9Volts2Ground/RBE598/latex/RBE598_Project.tex

\documentclass[twocolumn]{article}
\usepackage[utf8]{inputenc}
\usepackage[margin=0.7in]{geometry}
\usepackage{lipsum}
\usepackage[utf8]{inputenc}
% \usepackage[margin = 0.8in]{geometry}
\usepackage{subcaption}
\usepackage{multirow}
\usepackage{float}
\usepackage{gensymb}
\usepackage{graphicx}
\usepackage{amsmath}
\usepackage{tabularx}
\usepackage{adjustbox}
\setcounter{MaxMatrixCols}{20}

\usepackage[utf8]{inputenc}
\usepackage[english]{babel}

\usepackage{biblatex}
\addbibresource{bibliography.bib}

\begin{document}

\title{ Kinematics, Pose Control, and Motion Planning of Mobile Hexapod Robot }

\author{ S. Adam Stringham }

\maketitle
\thispagestyle{plain}
\pagestyle{plain}

%==============================================================================
\input{./01_abstract/abstract.tex}

\input{./02_introduction/introduction.tex}

\input{./03_related_work/related_work.tex}

\input{./04_robot_system/robot_system.tex}

\input{./05_methods/methods.tex}

\input{./06_results/results.tex}

\input{./07_discussion/discussion.tex}

%==============================================================================
\printbibliography

\end{document}
