9Volts2Ground/RBE598/latex/05_methods/methods.tex

%==============================================================================
\section{ Methods }

This project focused on three primary areas related to this hexapod robot: analytically constraining the body pose orientation, controlling the body pose, and implementing global motion planning. The approach for each of these tasks are described in this section. 

\input{./05_methods/kinematics.tex}

\input{./05_methods/control.tex}

\input{./05_methods/motion_planning.tex}
