9Volts2Ground/RBE598/latex/04_robot_system/figures/camera.png

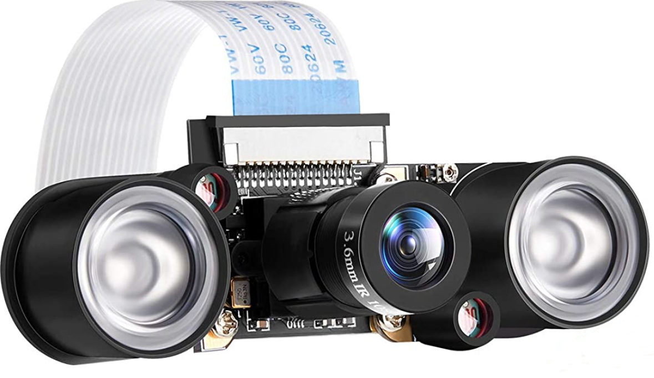
latex/04_robot_system/figures/camera.png
