9Volts2Ground/RBE598/latex/place_holder.png

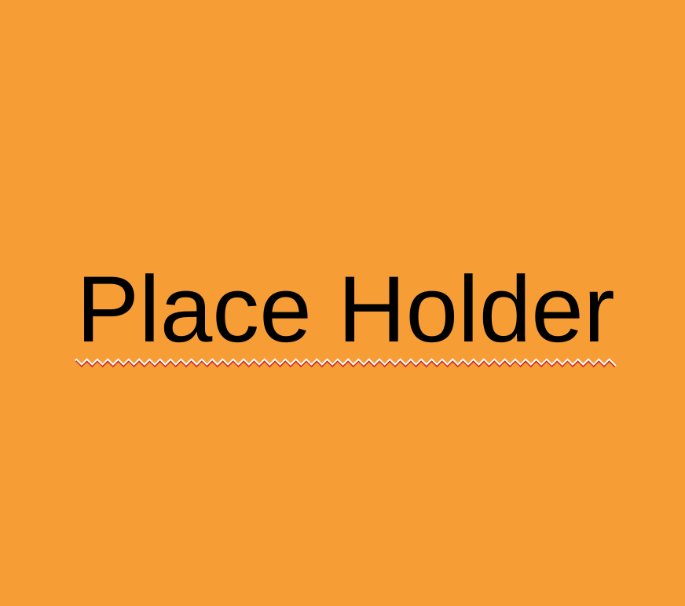
latex/place_holder.png
