9Volts2Ground/RBE598/Wanda/matlab/jacobian.png

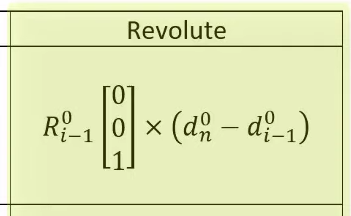
Wanda/matlab/jacobian.png
