9Volts2Ground/RBE598/Wanda/ROS/src/navigation_stack/maps/apartment.jpeg

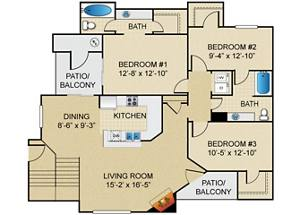
Wanda/ROS/src/navigation_stack/maps/apartment.jpeg
