9Volts2Ground/RBE598/Wanda/CAD/solidworks/body/body_full_assembly.SLDASM

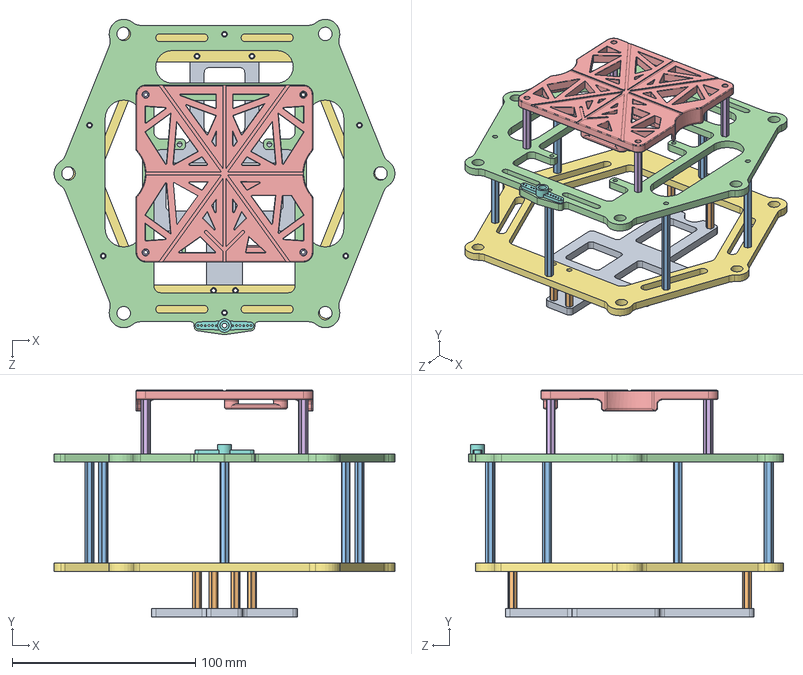
[picture p13: CAD file, 2023-04-29]
Wanda/CAD/solidworks/body/body_full_assembly.SLDASM
186.1 x 123.6 x 172.1 mm
belly_plate
brass_standoff_bot x 4
brass_standoff_mid x 6
body_upper_plate
top_plate_mk2_2
brass_standoff_top x 4
body_lower_plate_mk2
Microservo horn
