9Volts2Ground/RBE598/Wanda/CAD/solidworks/legs/link_3_right.SLDASM

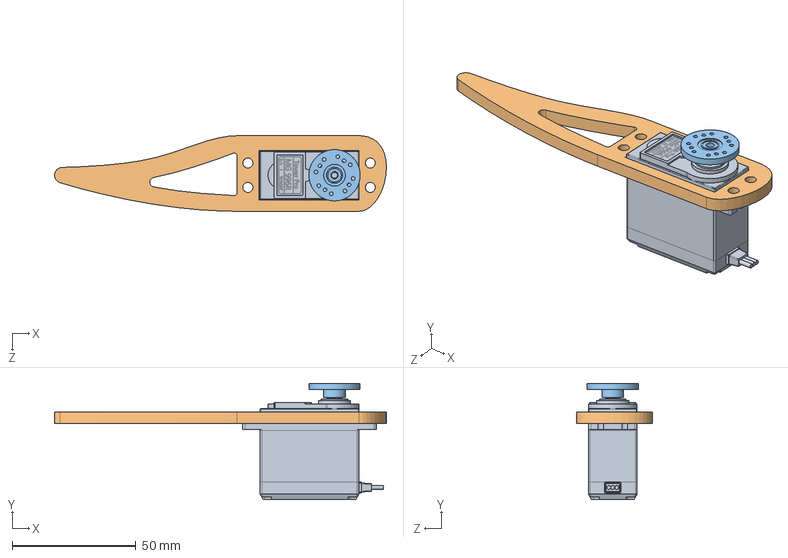
[picture p15: CAD file, 2023-04-29]
Wanda/CAD/solidworks/legs/link_3_right.SLDASM
134.1 x 46.9 x 30.6 mm
servoMotorMG996R
link_3
attachmentCircular
