9Volts2Ground/RBE598/Wanda/CAD/solidworks/legs/link_1_left.SLDASM

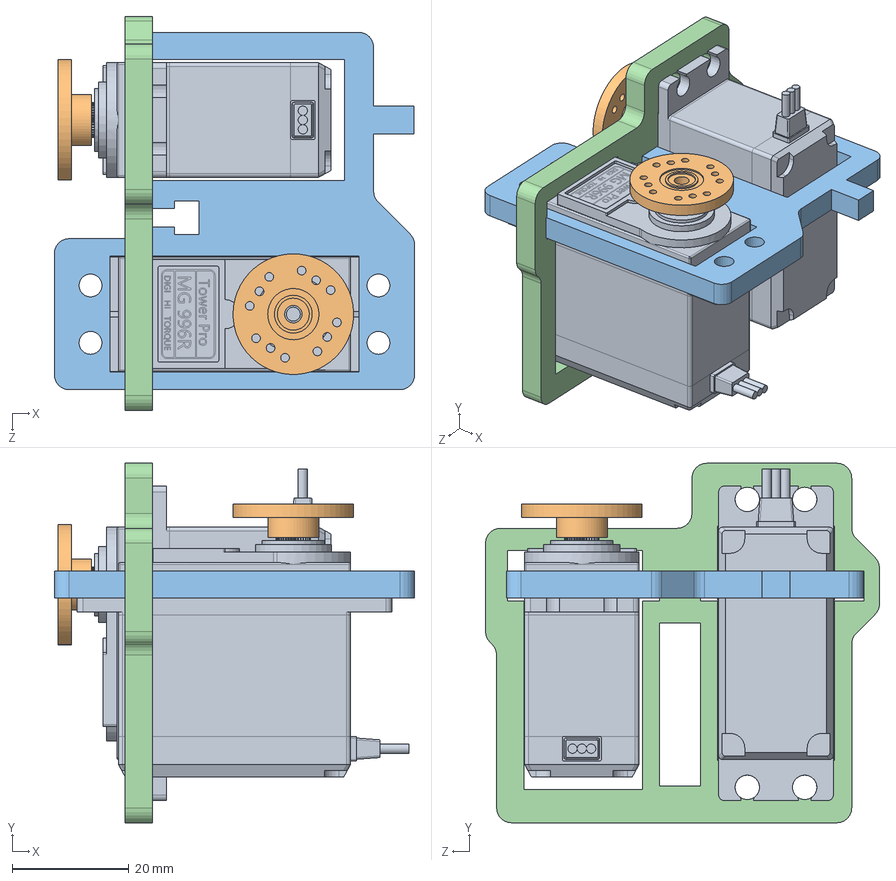
[picture p16: CAD file, 2023-04-29]
Wanda/CAD/solidworks/legs/link_1_left.SLDASM
61.8 x 61.7 x 67.6 mm
servoMotorMG996R x 2
attachmentCircular x 2
link_1_pt1
link_1_pt2
