9Volts2Ground/RBE598/Wanda/CAD/solidworks/seeker/neck.SLDASM

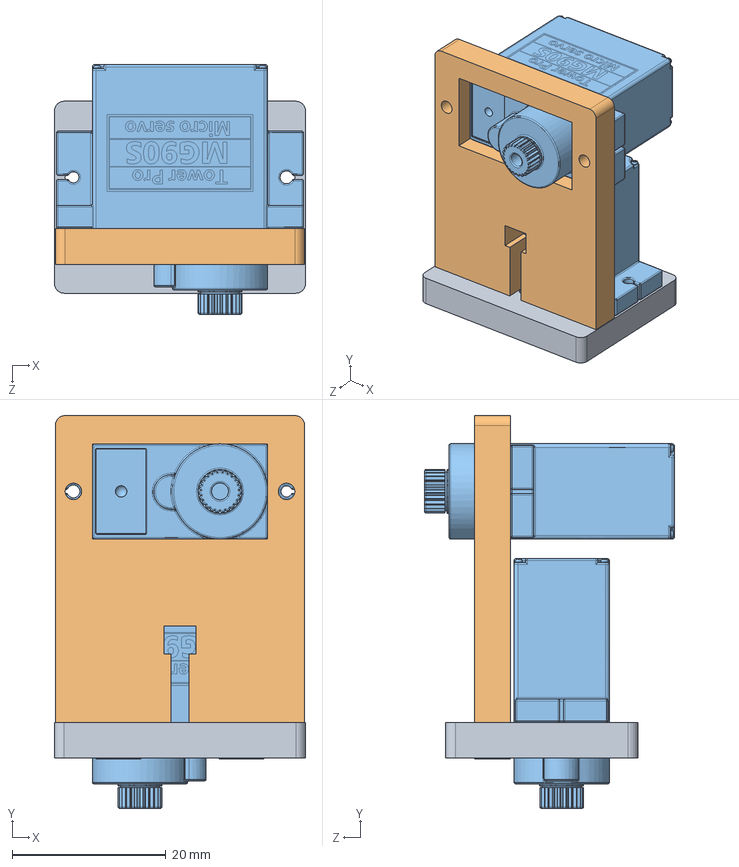
[picture p17: CAD file, 2023-04-29]
Wanda/CAD/solidworks/seeker/neck.SLDASM
32.6 x 51.1 x 32.5 mm
neck_lower_plate
neck_side_plate
Tower-Pro-MG90S x 2
