9Volts2Ground/RBE598/Wanda/CAD/solidworks/body/ssd_bracket/ssd_bracket_assembly.SLDASM

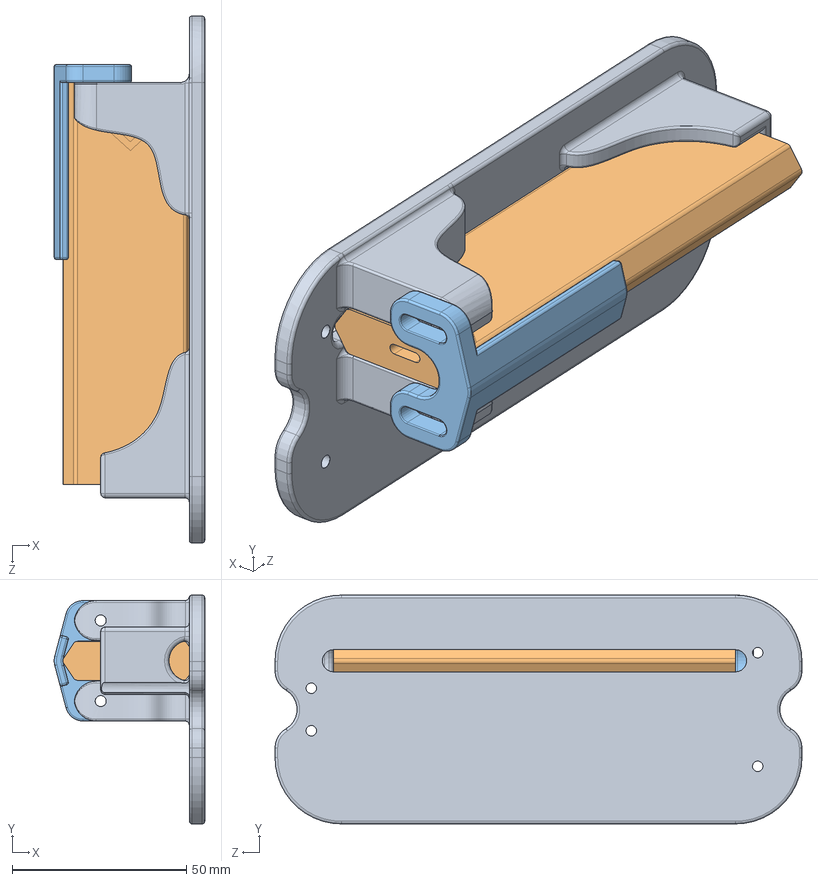
[picture p18: CAD file, 2023-04-29]
Wanda/CAD/solidworks/body/ssd_bracket/ssd_bracket_assembly.SLDASM
43.2 x 65.6 x 151.1 mm
ssd_adapter
ssd_bracket_lower
ssd_bracket_top
