9Volts2Ground/RBE598/Wanda/CAD/solidworks/legs/leg_right.SLDASM

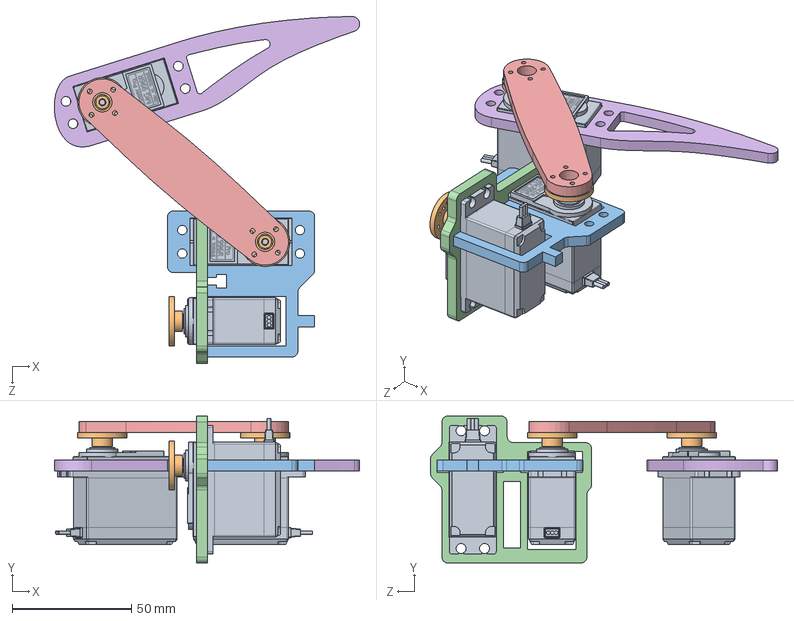
[picture p19: CAD file, 2023-04-29]
Wanda/CAD/solidworks/legs/leg_right.SLDASM
128.2 x 61.7 x 145.7 mm
servoMotorMG996R x 3
attachmentCircular x 3
link_1_pt1
link_1_pt2
link_2
link_3
