9Volts2Ground/RBE598/Wanda/CAD/solidworks/legs/servo-motor-mg996r-1.snapshot.1/servo_and_mount.SLDASM

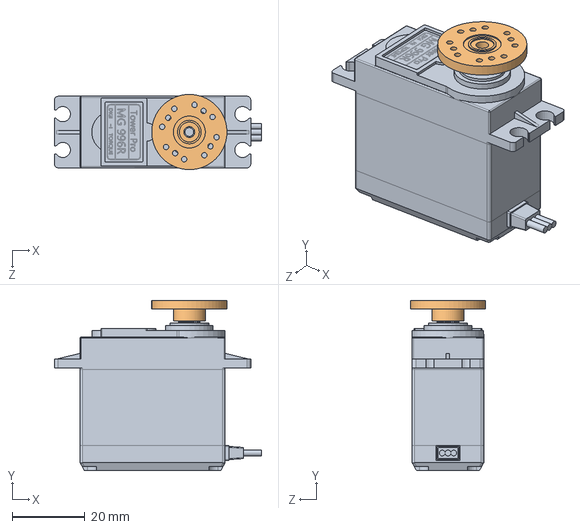
[picture p20: CAD file, 2023-04-29]
Wanda/CAD/solidworks/legs/servo-motor-mg996r-1.snapshot.1/servo_and_mount.SLDASM
57.0 x 46.9 x 20.7 mm
servoMotorMG996R
attachmentCircular
