9Volts2Ground/RBE598/Wanda/CAD/solidworks/seeker/Camera Module NVision Assem.SLDASM

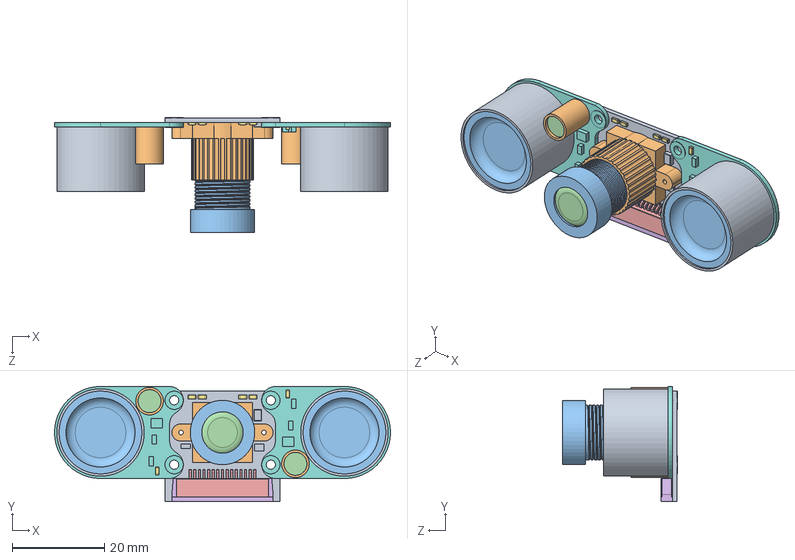
[picture p21: CAD file, 2023-04-29]
Wanda/CAD/solidworks/seeker/Camera Module NVision Assem.SLDASM
73.0 x 25.0 x 25.0 mm
PCB 1
Camera Block
Camera end
Lenz
15 Pin Ribbon Block
Ribbon Clamp
0603 Resistor x 6
IR PCB x 2
IR Cup x 2
IR Light Sensor x 2
IR Lenz 18mm x 2
Light Sensor Lenz x 2
