9Volts2Ground/RBE598/Wanda/CAD/solidworks/legs/leg_left.SLDASM

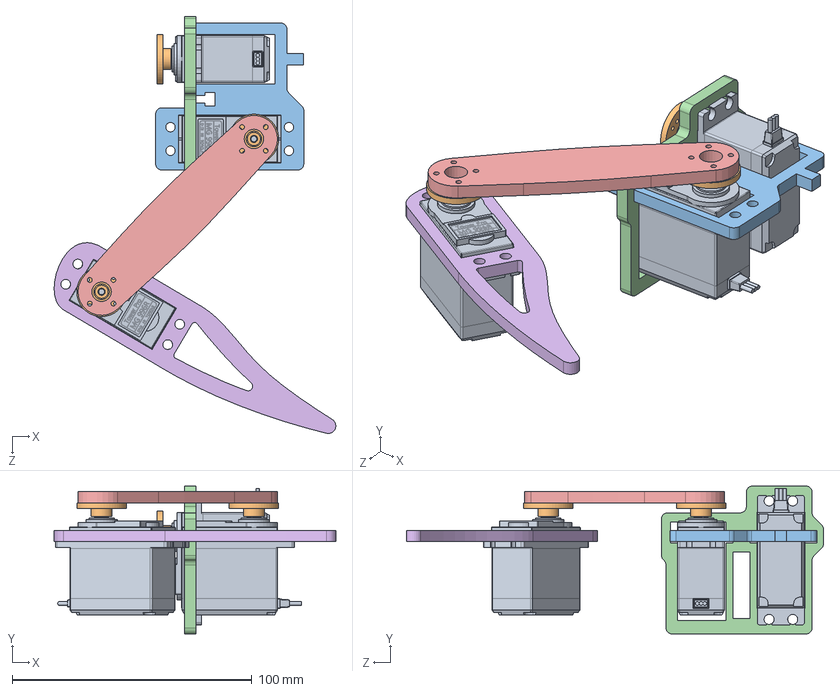
[picture p22: CAD file, 2023-04-29]
Wanda/CAD/solidworks/legs/leg_left.SLDASM
117.6 x 61.7 x 174.0 mm
servoMotorMG996R x 3
attachmentCircular x 3
link_1_pt1
link_1_pt2
link_2
link_3
