9Volts2Ground/RBE598/Wanda/CAD/solidworks/seeker/Servo_With_Horn.SLDASM

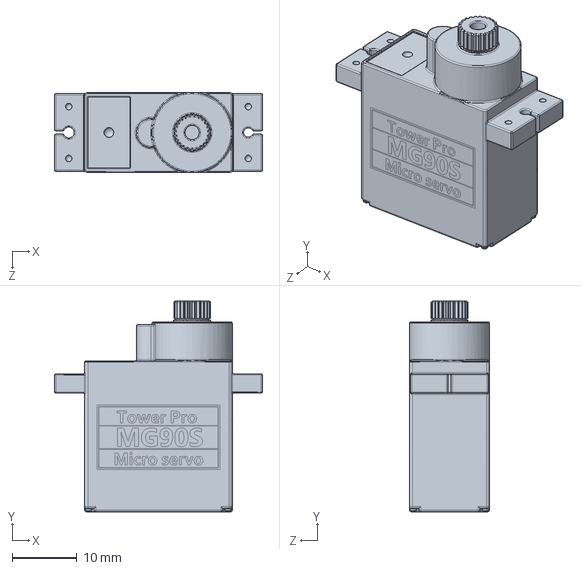
[picture p23: CAD file, 2023-04-29]
Wanda/CAD/solidworks/seeker/Servo_With_Horn.SLDASM
32.1 x 32.5 x 12.4 mm
