9Volts2Ground/RBE598/Wanda/CAD/solidworks/body/body_plates/belly_plate.SLDPRT

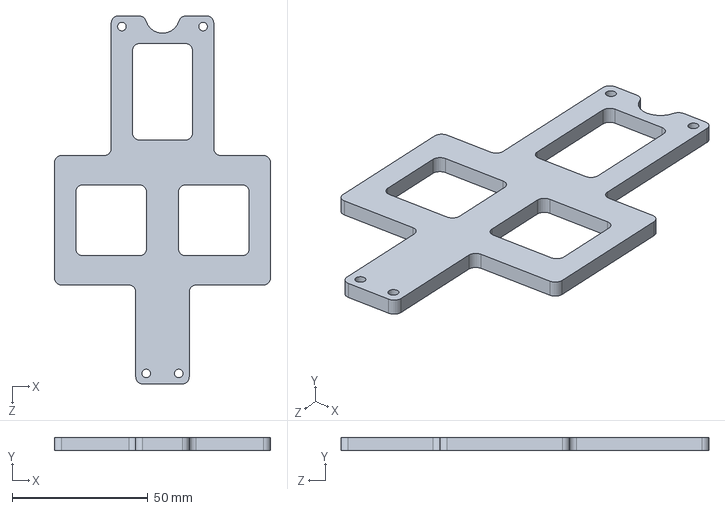
[picture p24: CAD file, 2023-04-29]
Wanda/CAD/solidworks/body/body_plates/belly_plate.SLDPRT
79.7 x 4.65 x 135.7 mm
