9Volts2Ground/RBE598/Wanda/CAD/solidworks/body/ssd_bracket/ssd_bracket_top.SLDPRT

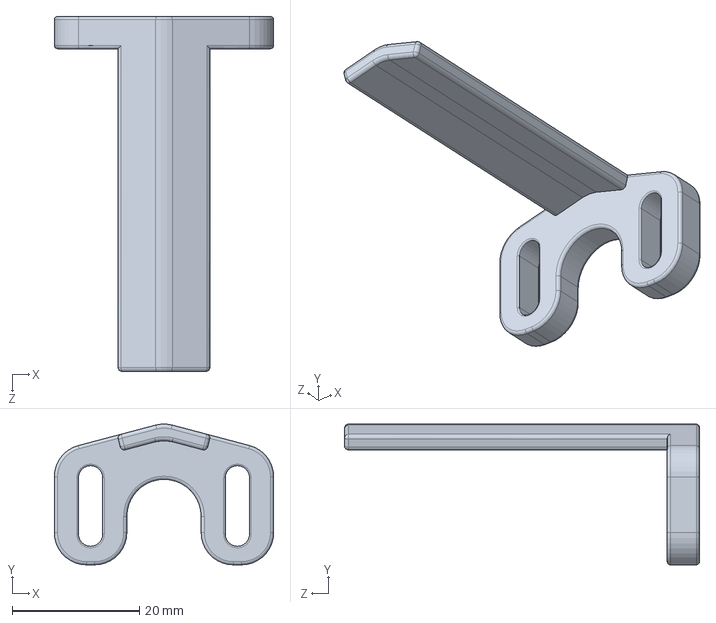
[picture p25: CAD file, 2023-04-29]
Wanda/CAD/solidworks/body/ssd_bracket/ssd_bracket_top.SLDPRT
34.5 x 22.2 x 55.9 mm
