9Volts2Ground/RBE598/Wanda/CAD/solidworks/body/standoffs/brass_standoff_mid.SLDPRT

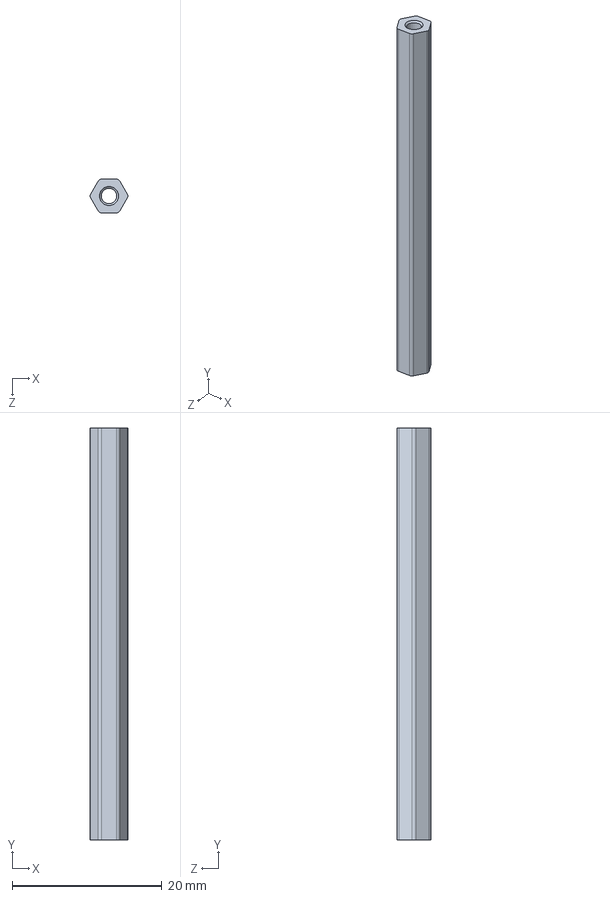
[picture p26: CAD file, 2023-04-29]
Wanda/CAD/solidworks/body/standoffs/brass_standoff_mid.SLDPRT
5.05 x 55.1 x 4.51 mm
