9Volts2Ground/RBE598/Wanda/CAD/solidworks/legs/servo-motor-mg996r-1.snapshot.1/attachmentStraight.SLDPRT

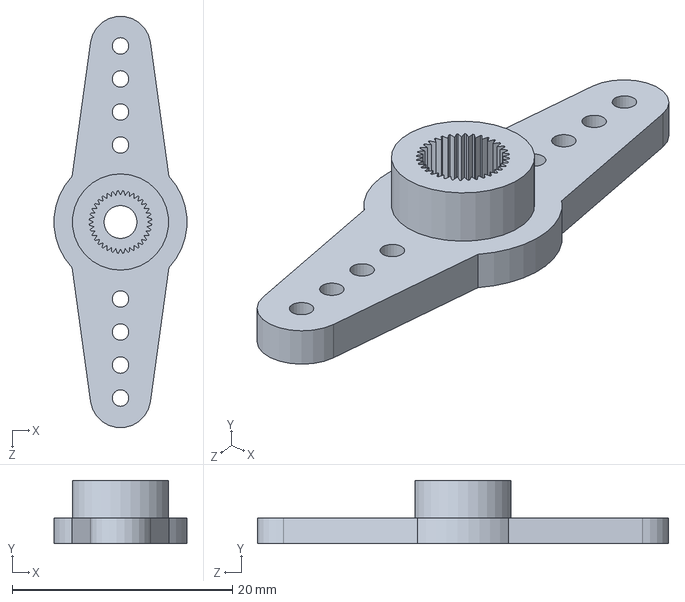
[picture p27: CAD file, 2023-04-29]
Wanda/CAD/solidworks/legs/servo-motor-mg996r-1.snapshot.1/attachmentStraight.SLDPRT
12.1 x 5.75 x 37.4 mm
