9Volts2Ground/RBE598/Wanda/ROS/src/wanda_model/meshes/link_1_right.STL

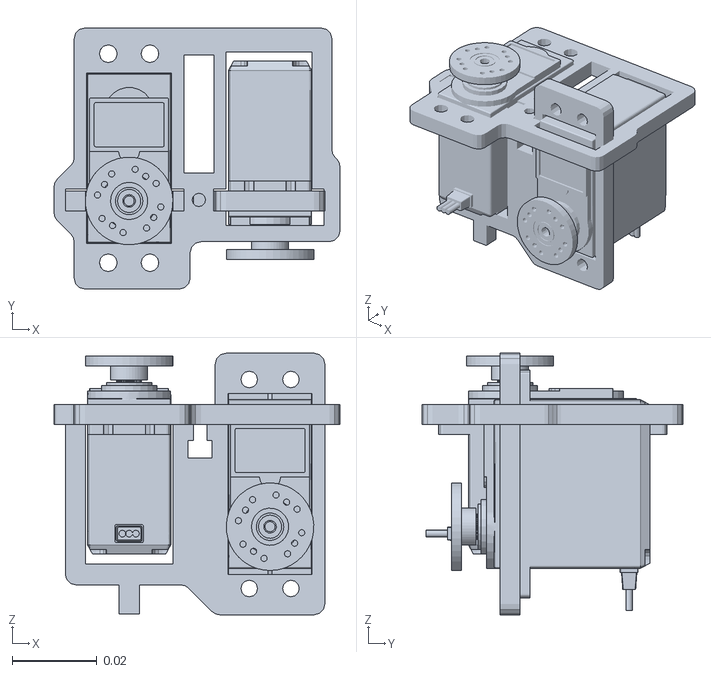
[picture p28: CAD file, 2023-04-29]
Wanda/ROS/src/wanda_model/meshes/link_1_right.STL
0.0676 x 0.0617 x 0.0618
