9Volts2Ground/RBE598/Wanda/CAD/solidworks/body/body_plates/body_lower_plate_mk2.SLDPRT

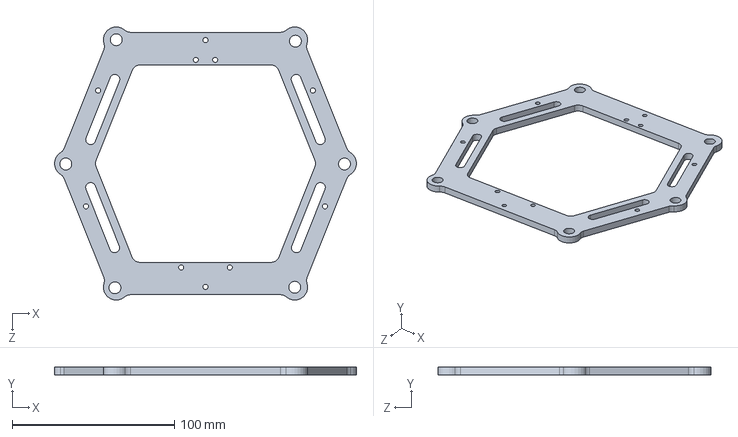
[picture p29: CAD file, 2023-04-29]
Wanda/CAD/solidworks/body/body_plates/body_lower_plate_mk2.SLDPRT
186.1 x 4.62 x 168.3 mm
