9Volts2Ground/RBE598/Wanda/CAD/solidworks/body/ssd_bracket/ssd_adapter.SLDPRT

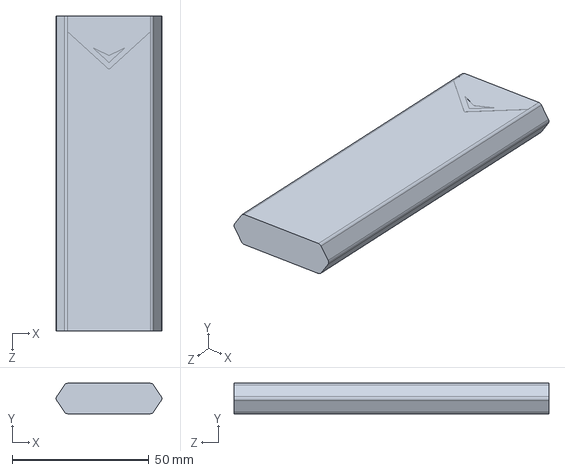
[picture p30: CAD file, 2023-04-29]
Wanda/CAD/solidworks/body/ssd_bracket/ssd_adapter.SLDPRT
38.7 x 11.2 x 115.3 mm
