9Volts2Ground/RBE598/Wanda/CAD/solidworks/body/standoffs/brass_standoff_bot.SLDPRT

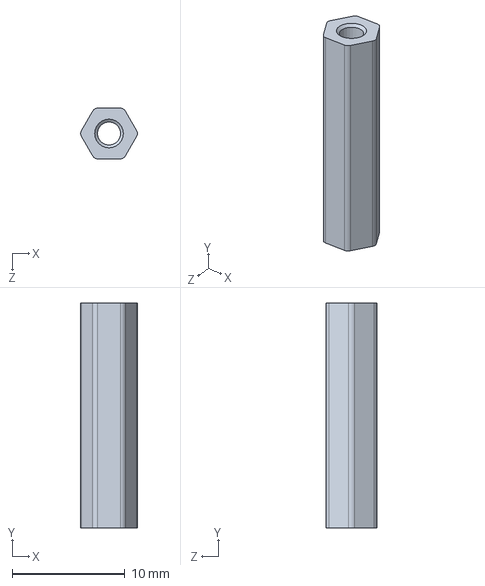
[picture p31: CAD file, 2023-04-29]
Wanda/CAD/solidworks/body/standoffs/brass_standoff_bot.SLDPRT
5.05 x 20.0 x 4.51 mm
