9Volts2Ground/RBE598/Wanda/CAD/solidworks/legs/servo-motor-mg996r-1.snapshot.1/attachmentStar.SLDPRT

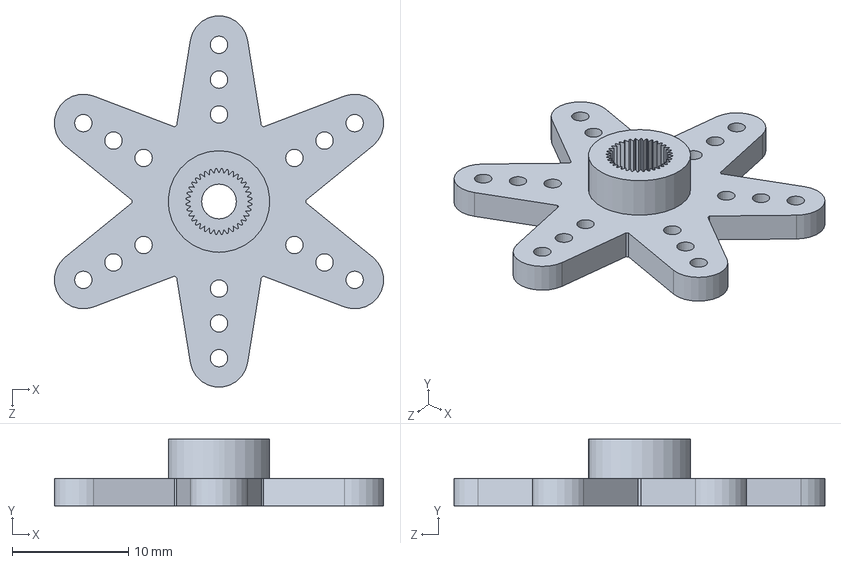
[picture p32: CAD file, 2023-04-29]
Wanda/CAD/solidworks/legs/servo-motor-mg996r-1.snapshot.1/attachmentStar.SLDPRT
28.3 x 5.75 x 32.0 mm
