9Volts2Ground/RBE598/Wanda/CAD/solidworks/seeker/seeker_face_plate_mk2.SLDPRT

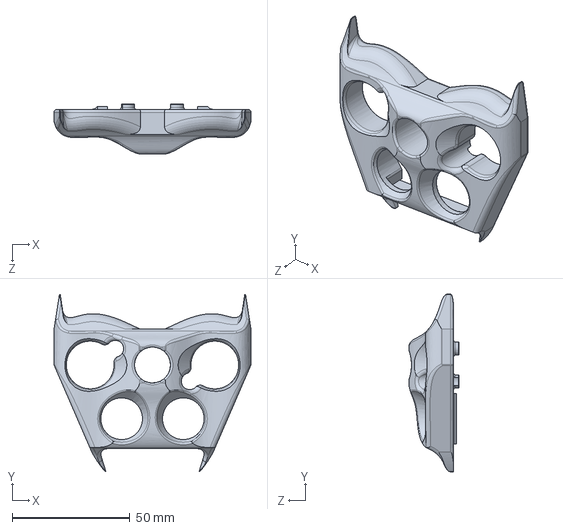
[picture p33: CAD file, 2023-04-29]
Wanda/CAD/solidworks/seeker/seeker_face_plate_mk2.SLDPRT
83.8 x 75.5 x 21.3 mm
