9Volts2Ground/RBE598/Wanda/ROS/src/wanda_model/meshes/link_3_left.STL

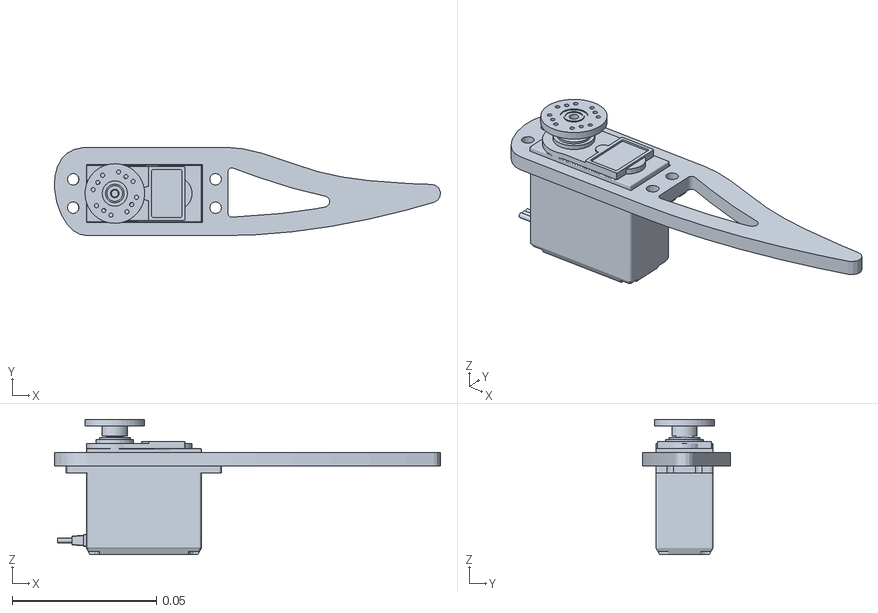
[picture p34: CAD file, 2023-04-29]
Wanda/ROS/src/wanda_model/meshes/link_3_left.STL
0.134 x 0.0306 x 0.0469
