9Volts2Ground/RBE598/Wanda/CAD/solidworks/body/body_plates/body_upper_plate.SLDPRT

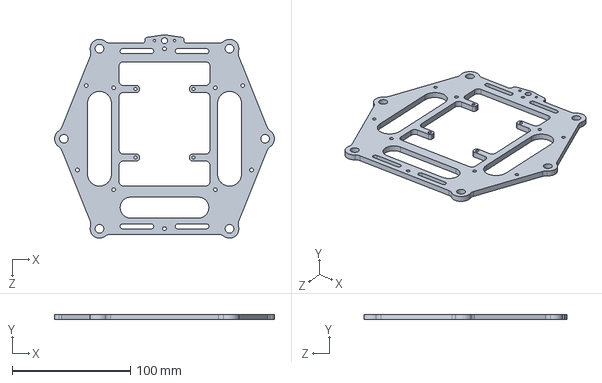
[picture p35: CAD file, 2023-04-29]
Wanda/CAD/solidworks/body/body_plates/body_upper_plate.SLDPRT
186.1 x 4.62 x 172.0 mm
