9Volts2Ground/RBE598/Wanda/CAD/solidworks/body/ssd_bracket/ssd_bracket_lower.SLDPRT

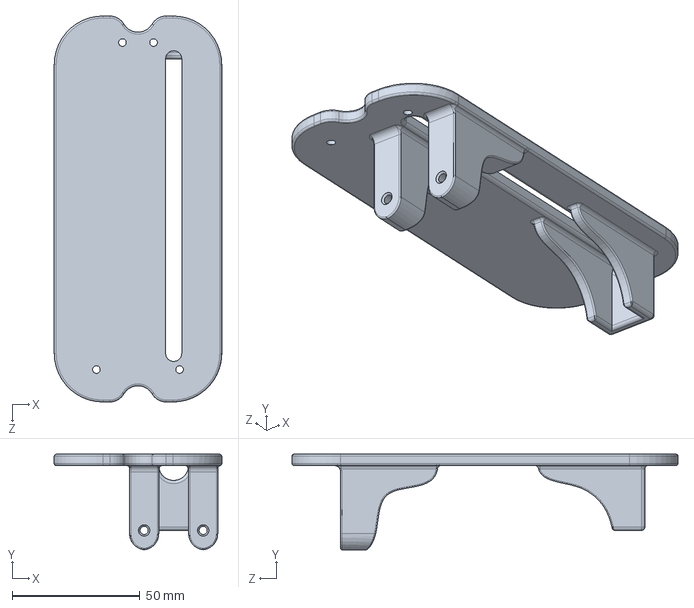
[picture p36: CAD file, 2023-04-29]
Wanda/CAD/solidworks/body/ssd_bracket/ssd_bracket_lower.SLDPRT
65.6 x 37.4 x 151.1 mm
