9Volts2Ground/RBE598/Wanda/CAD/solidworks/body/standoffs/brass_standoff_top.SLDPRT

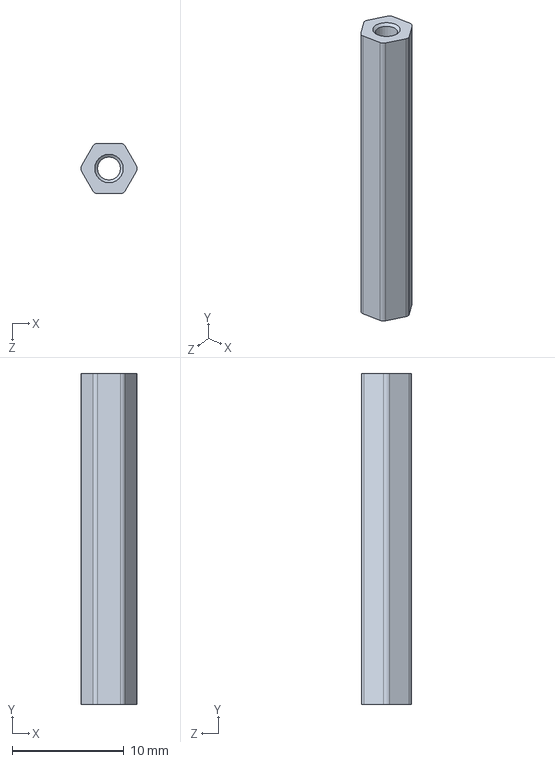
[picture p37: CAD file, 2023-04-29]
Wanda/CAD/solidworks/body/standoffs/brass_standoff_top.SLDPRT
5.04 x 29.6 x 4.51 mm
