9Volts2Ground/RBE598/Wanda/CAD/solidworks/legs/servo-motor-mg996r-1.snapshot.1/servoMotorMG996R.SLDPRT

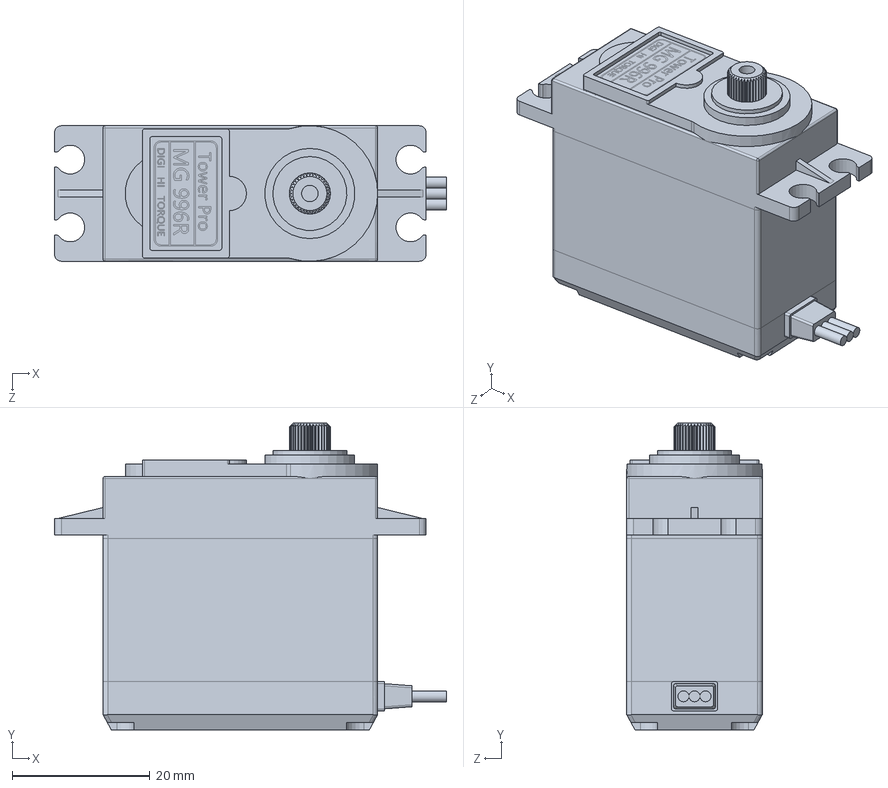
[picture p38: CAD file, 2023-04-29]
Wanda/CAD/solidworks/legs/servo-motor-mg996r-1.snapshot.1/servoMotorMG996R.SLDPRT
57.0 x 44.5 x 19.7 mm
