9Volts2Ground/RBE598/Wanda/CAD/solidworks/body/body_plates/top_plate_mk2_2.SLDPRT

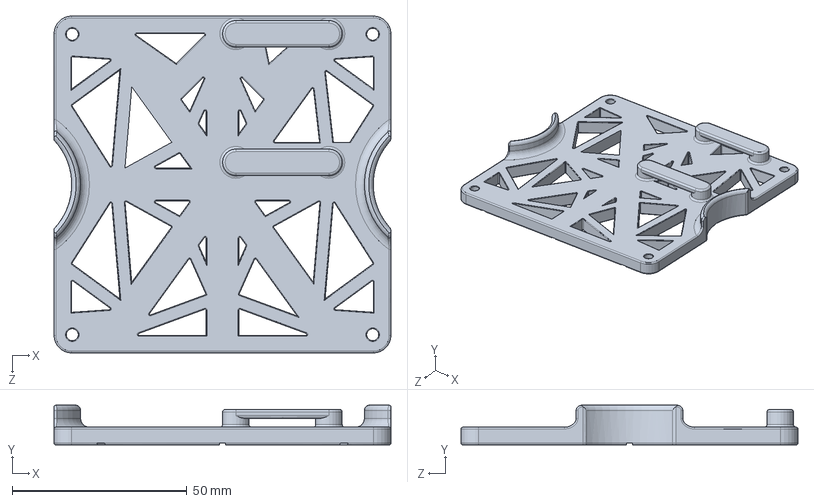
[picture p39: CAD file, 2023-04-29]
Wanda/CAD/solidworks/body/body_plates/top_plate_mk2_2.SLDPRT
96.5 x 11.4 x 96.5 mm
