9Volts2Ground/RBE598/Wanda/CAD/solidworks/legs/servo-motor-mg996r-1.snapshot.1/attachmentCircular.SLDPRT

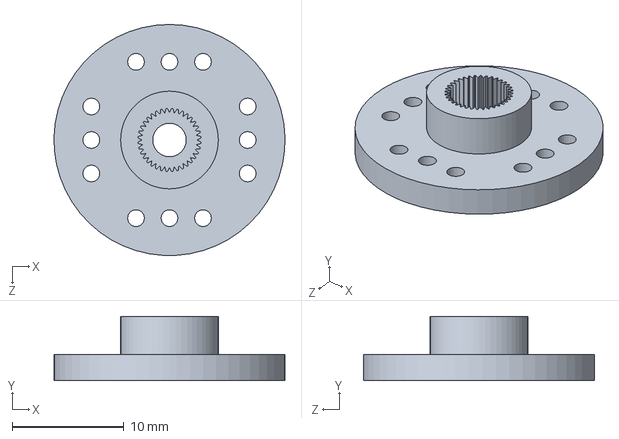
[picture p40: CAD file, 2023-04-29]
Wanda/CAD/solidworks/legs/servo-motor-mg996r-1.snapshot.1/attachmentCircular.SLDPRT
20.7 x 5.75 x 20.7 mm
