9Volts2Ground/RBE598/Wanda/CAD/solidworks/seeker/HC-SR04-UltrasonicSensor v7.step.STL

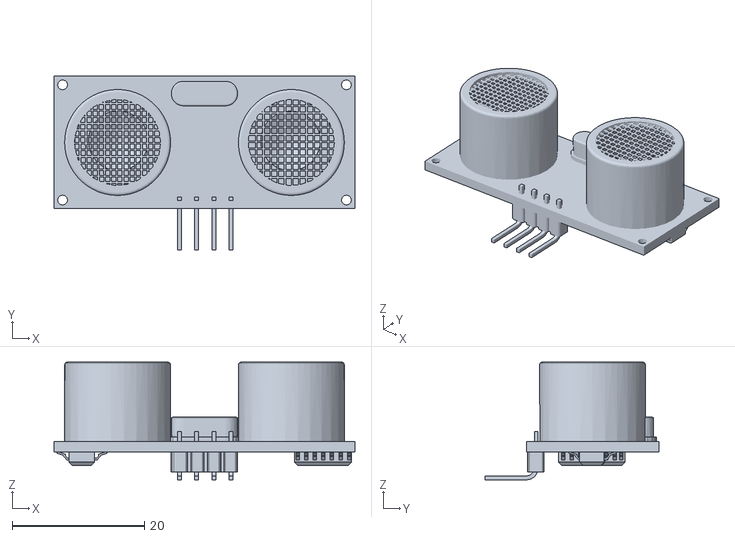
[picture p41: CAD file, 2023-04-29]
Wanda/CAD/solidworks/seeker/HC-SR04-UltrasonicSensor v7.step.STL
45.4 x 26.2 x 17.8
