9Volts2Ground/RBE598/Wanda/CAD/solidworks/body/body_plates/body_lower_plate.SLDPRT

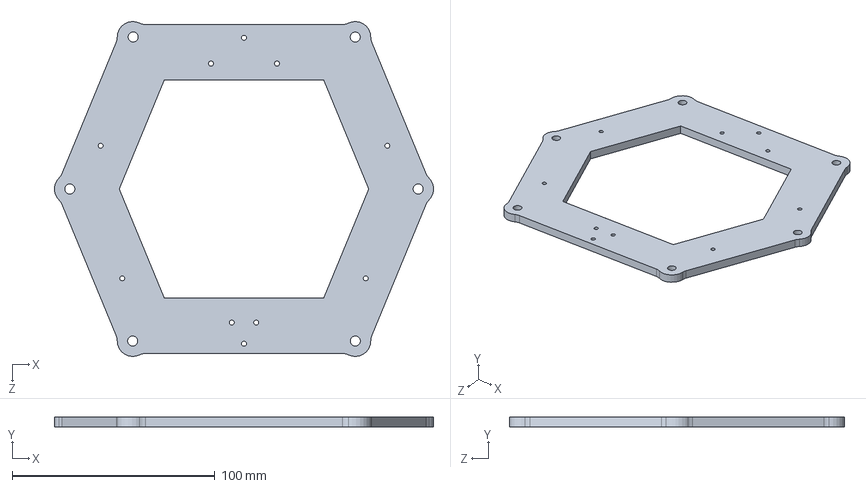
[picture p42: CAD file, 2023-04-29]
Wanda/CAD/solidworks/body/body_plates/body_lower_plate.SLDPRT
187.1 x 4.78 x 165.3 mm
