9Volts2Ground/RBE598/Wanda/CAD/solidworks/legs/link_3.SLDPRT

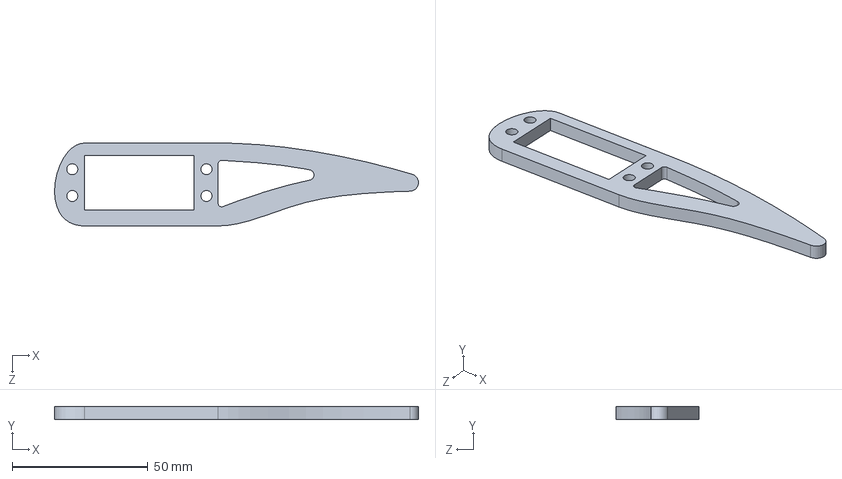
[picture p43: CAD file, 2023-04-29]
Wanda/CAD/solidworks/legs/link_3.SLDPRT
134.1 x 4.70 x 30.6 mm
