9Volts2Ground/RBE598/Wanda/CAD/solidworks/legs/servo-motor-mg996r-1.snapshot.1/attachmentCross.SLDPRT

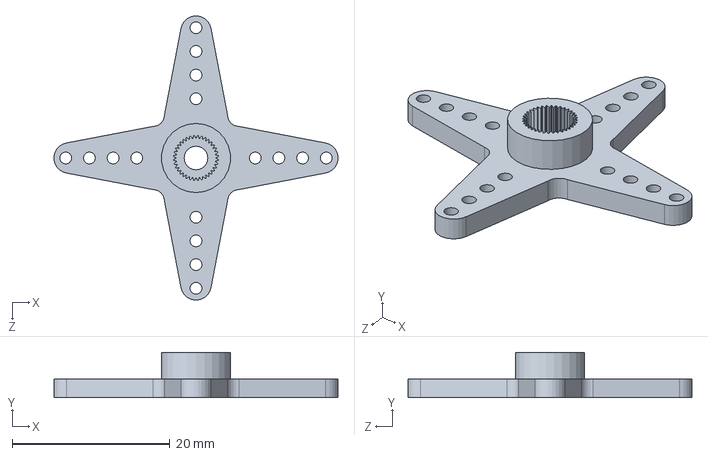
[picture p44: CAD file, 2023-04-29]
Wanda/CAD/solidworks/legs/servo-motor-mg996r-1.snapshot.1/attachmentCross.SLDPRT
36.0 x 5.75 x 36.0 mm
