9Volts2Ground/RBE598/Wanda/CAD/solidworks/seeker/neck_side_plate.SLDPRT

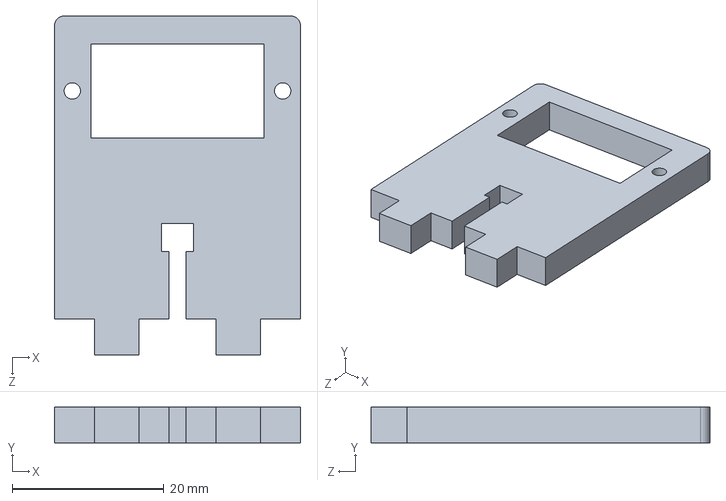
[picture p45: CAD file, 2023-04-29]
Wanda/CAD/solidworks/seeker/neck_side_plate.SLDPRT
32.4 x 4.70 x 44.6 mm
