9Volts2Ground/RBE598/Wanda/ROS/src/wanda_model/meshes/link_2.STL

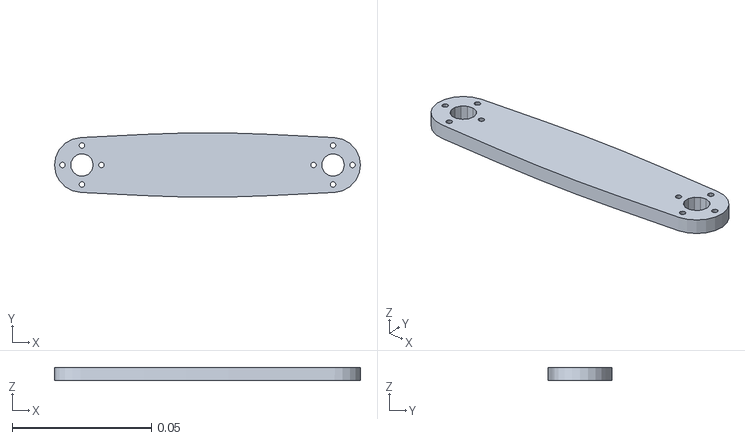
[picture p46: CAD file, 2023-04-29]
Wanda/ROS/src/wanda_model/meshes/link_2.STL
0.11 x 0.023 x 0.00475
