9Volts2Ground/RBE598/Wanda/CAD/solidworks/body/body_plates/top_plate.SLDPRT

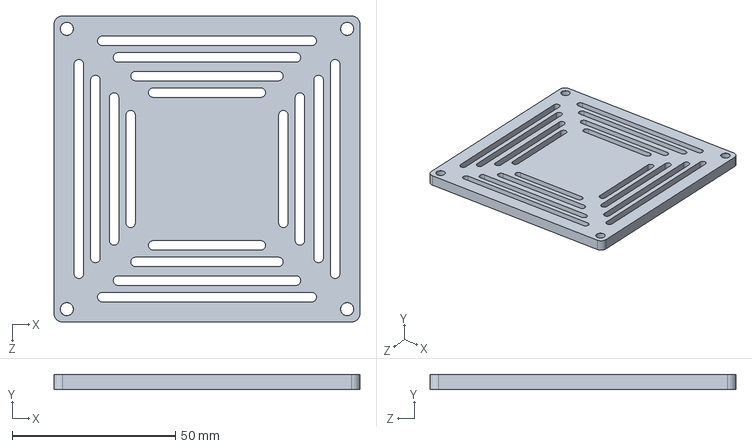
[picture p47: CAD file, 2023-04-29]
Wanda/CAD/solidworks/body/body_plates/top_plate.SLDPRT
93.9 x 4.57 x 93.9 mm
