9Volts2Ground/RBE598/Wanda/CAD/solidworks/legs/link_1_pt1.SLDPRT

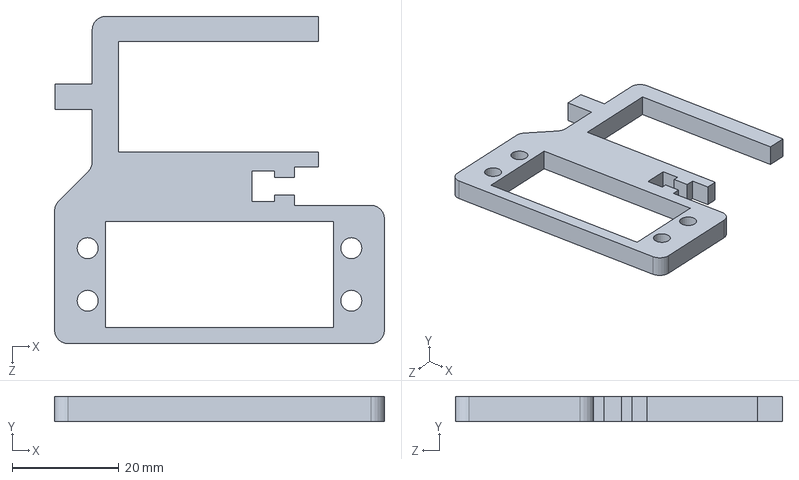
[picture p48: CAD file, 2023-04-29]
Wanda/CAD/solidworks/legs/link_1_pt1.SLDPRT
61.8 x 4.70 x 61.3 mm
