9Volts2Ground/RBE598/Wanda/CAD/solidworks/seeker/seeker_face_plate_mk3.SLDPRT

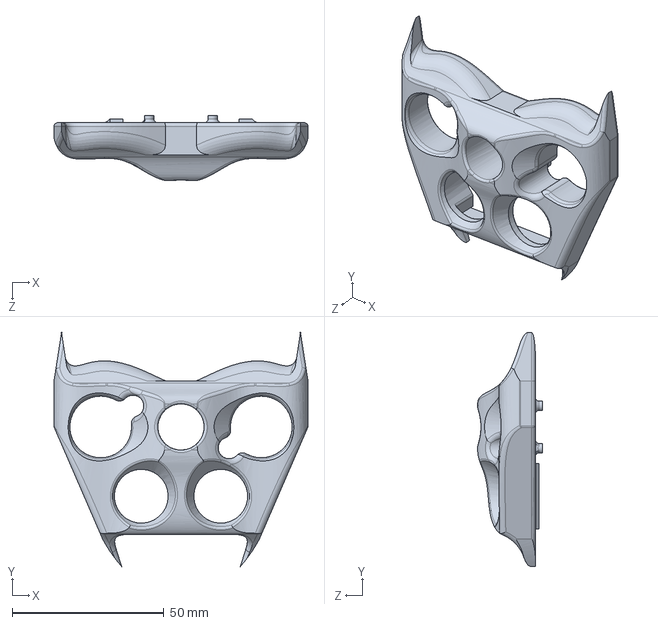
[picture p49: CAD file, 2023-04-29]
Wanda/CAD/solidworks/seeker/seeker_face_plate_mk3.SLDPRT
83.8 x 77.2 x 21.3 mm
