9Volts2Ground/RBE598/Wanda/CAD/solidworks/legs/link_2.SLDPRT

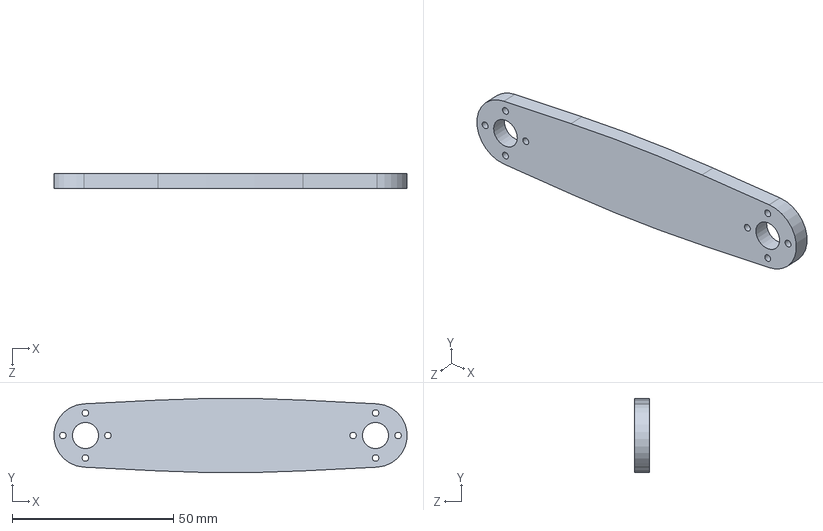
[picture p50: CAD file, 2023-04-29]
Wanda/CAD/solidworks/legs/link_2.SLDPRT
109.6 x 23.0 x 4.75 mm
