9Volts2Ground/RBE598/Wanda/CAD/solidworks/seeker/neck_lower_plate.SLDPRT

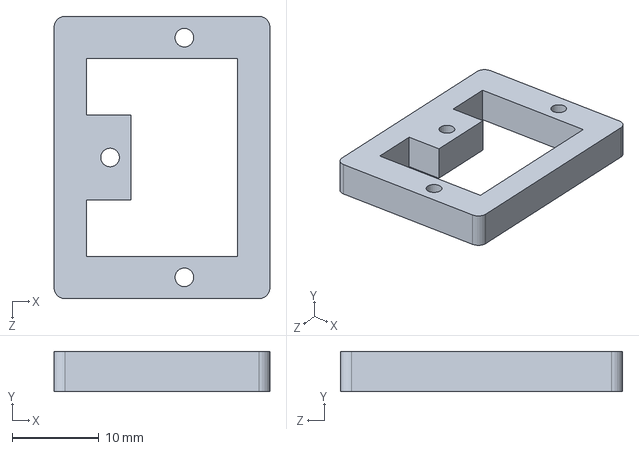
[picture p51: CAD file, 2023-04-29]
Wanda/CAD/solidworks/seeker/neck_lower_plate.SLDPRT
25.0 x 4.65 x 32.6 mm
