9Volts2Ground/RBE598/Wanda/CAD/solidworks/seeker/Microservo horn.SLDPRT

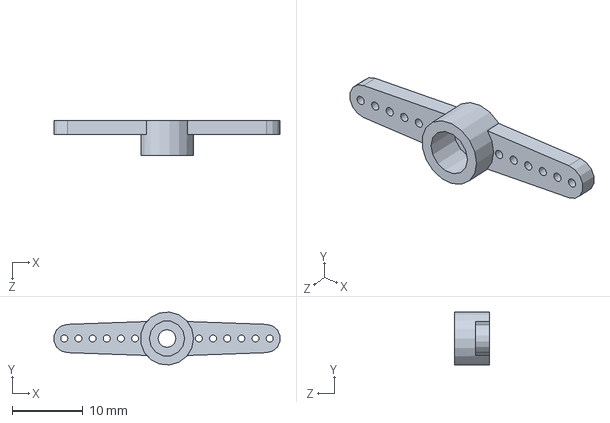
[picture p52: CAD file, 2023-04-29]
Wanda/CAD/solidworks/seeker/Microservo horn.SLDPRT
31.9 x 7.47 x 5.00 mm
