9Volts2Ground/RBE598/Wanda/CAD/solidworks/legs/link_1_pt2.SLDPRT

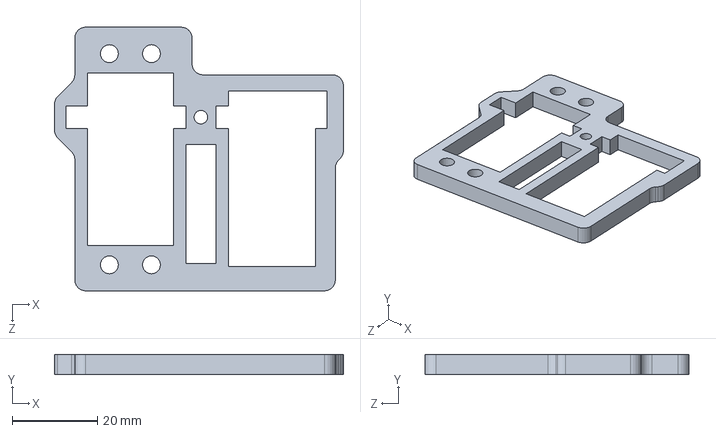
[picture p53: CAD file, 2023-04-29]
Wanda/CAD/solidworks/legs/link_1_pt2.SLDPRT
67.6 x 4.70 x 61.7 mm
