9Volts2Ground/RBE598/Wanda/CAD/solidworks/seeker/neck_bracket_mk2.SLDPRT

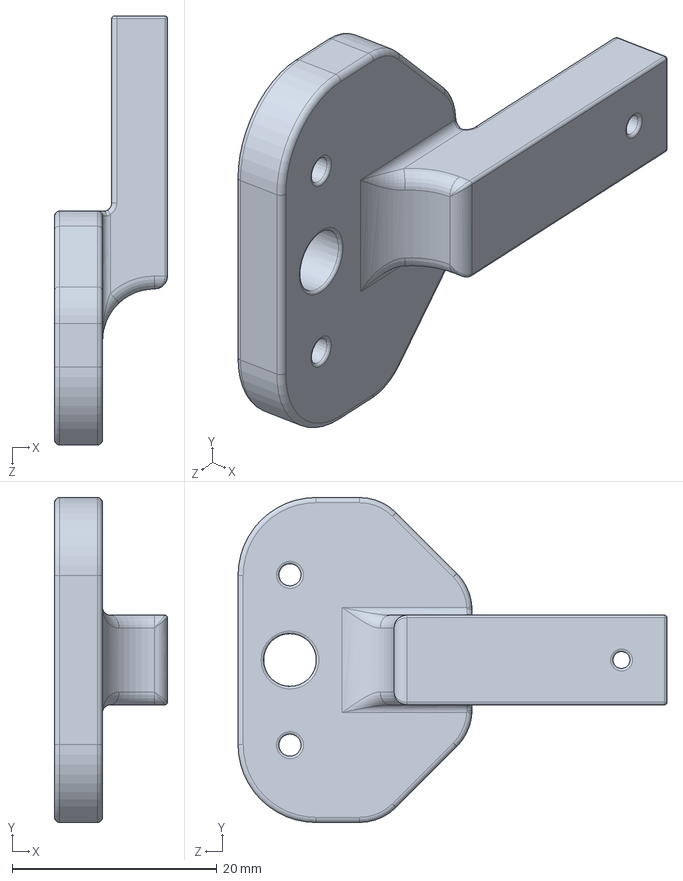
[picture p54: CAD file, 2023-04-29]
Wanda/CAD/solidworks/seeker/neck_bracket_mk2.SLDPRT
11.0 x 31.8 x 41.9 mm
