9Volts2Ground/RBE598/(list of files, cad)

Other CAD files:
Wanda/CAD/solidworks/legs/link_3_left.SLDASM
Wanda/CAD/solidworks/legs/link_1_right.SLDASM
Wanda/CAD/solidworks/seeker/Tower-Pro-MG90S.SLDPRT
Wanda/ROS/src/wanda_model/meshes/link_1_left.STL
Wanda/ROS/src/wanda_model/meshes/link_3_right.STL
Wanda/CAD/solidworks/seeker/HC-SR04-UltrasonicSensor v7.step1.SLDPRT
Wanda/CAD/solidworks/body/rpi4/Raspberry Pi 4 Model B.STL
Wanda/CAD/solidworks/seeker/Camera Module NVision Assem.STL
Wanda/CAD/solidworks/seeker/seeker_face_plate_mk3.STL
Wanda/CAD/stl/legs/link_1_left.STL
Wanda/CAD/stl/legs/link_1_pt1.STL
Wanda/CAD/stl/legs/link_1_pt2.STL
Wanda/CAD/stl/legs/link_3.STL
Wanda/CAD/stl/legs/link_3_right.STL
