9Volts2Ground/RBE598/latex/06_results/results.tex

%==============================================================================
\section{ Results}

\input{./06_results/kinematics_results.tex}

\input{./06_results/control_results.tex}

\input{./06_results/motion_planning_results.tex}
