9Volts2Ground/RBE598/latex/06_results/control_results.tex

\subsection{ Body Pose Control }
The following gain values were chosen through hand-tuning the system for speed and minimal overshoot. 

\[K_p = 1.0, K_d = 0.02, K_I = 0.02\]

\begin{figure}[H]
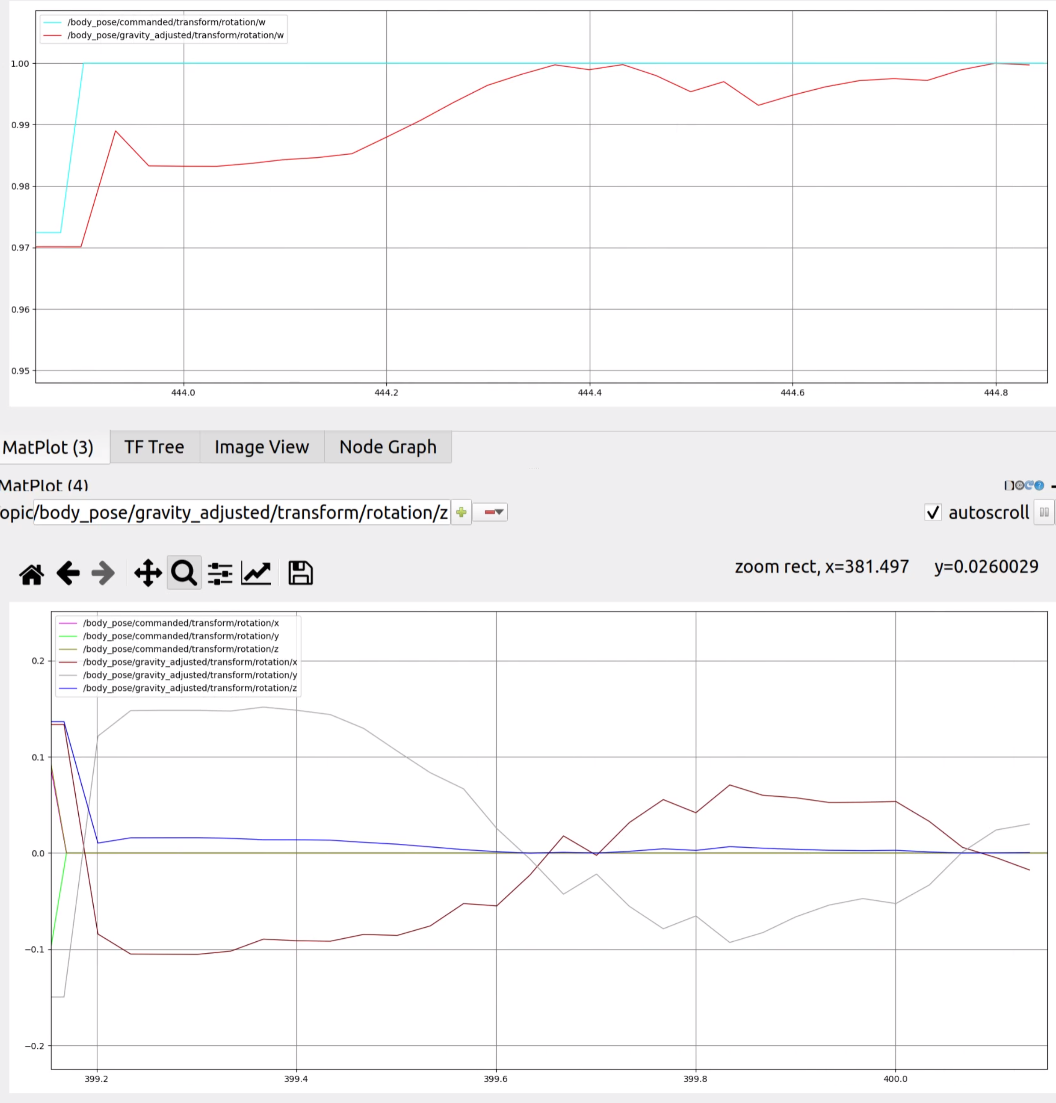
[picture p59: latex/06_results/figures/pose_step_control.png]
    \centerline{}
    \caption{ Body pose controller quaternion response to step change}
    \label{fig:pose_control_response}
\end{figure}

The body pose successfully achieves the desired orientation relative to gravity, despite the noisy sensor data. Even though the system as a whole has a high degree of dynamic complexity, the approach to commanding the body pose results in this controller behaving as expected when tuning a classical PID controller. An example system response can be seen in Figure \ref{fig:pose_control_response}. Notice the overshooting and slight underdamped behavior.
