9Volts2Ground/RBE598/latex/06_results/figures/imu_data.png

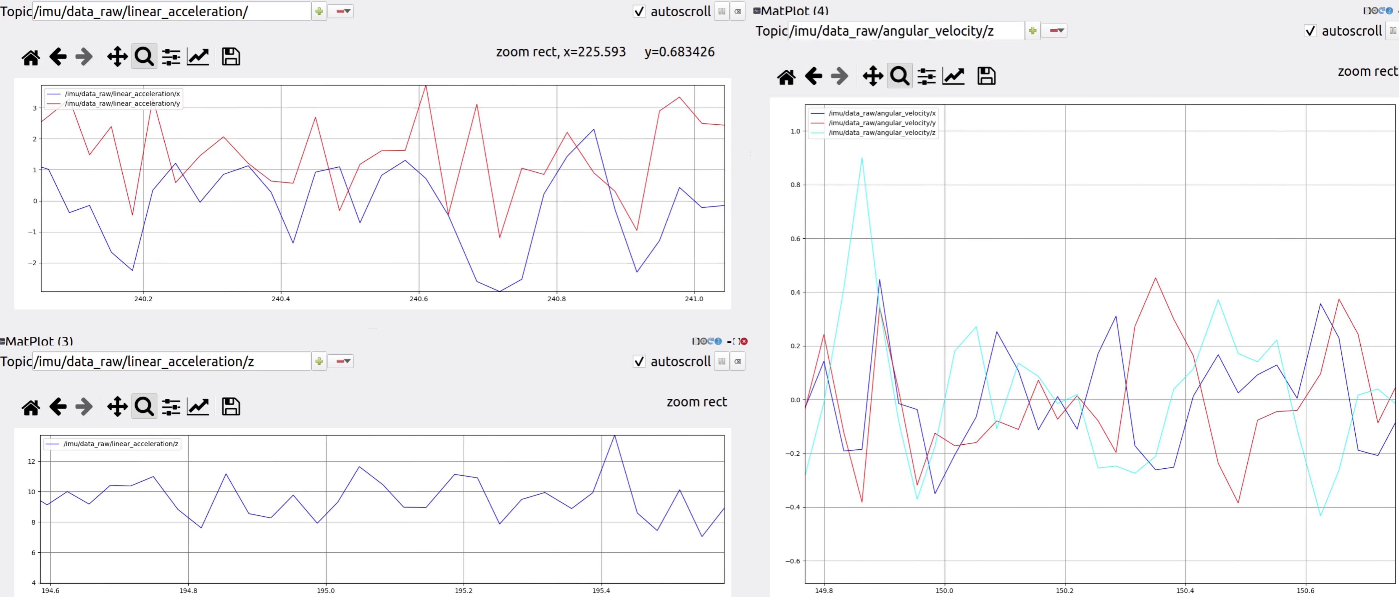
latex/06_results/figures/imu_data.png
